Stepka/NFC-Lock/(commit log)

2020-12-01 Added autoreset after 24 hours. It is a dirty bugfix for freeze after a while
    [NFCLock.ino]
2020-12-01 Updated reset without wiring
    [NFCLock.ino]
